dreiss/barrel-power-monitor/back-side.jpg

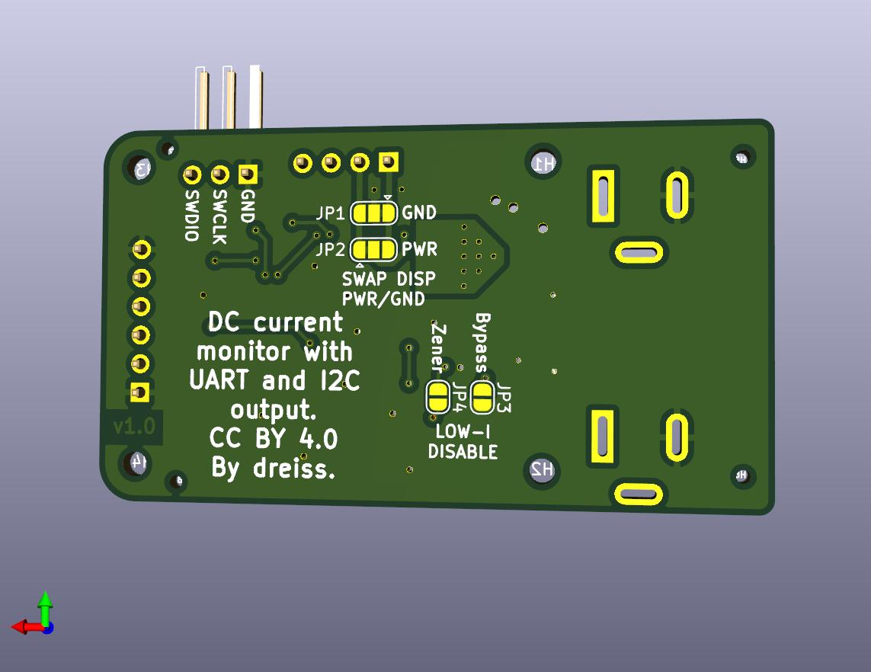
back-side.jpg
