dreiss/barrel-power-monitor/render.jpg

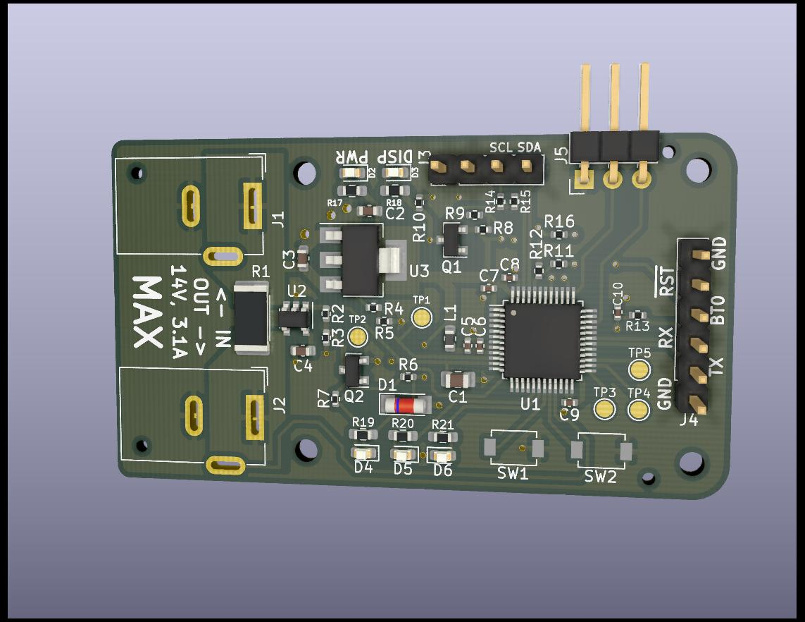
render.jpg
