dreiss/barrel-power-monitor/pcb-screenshot.png

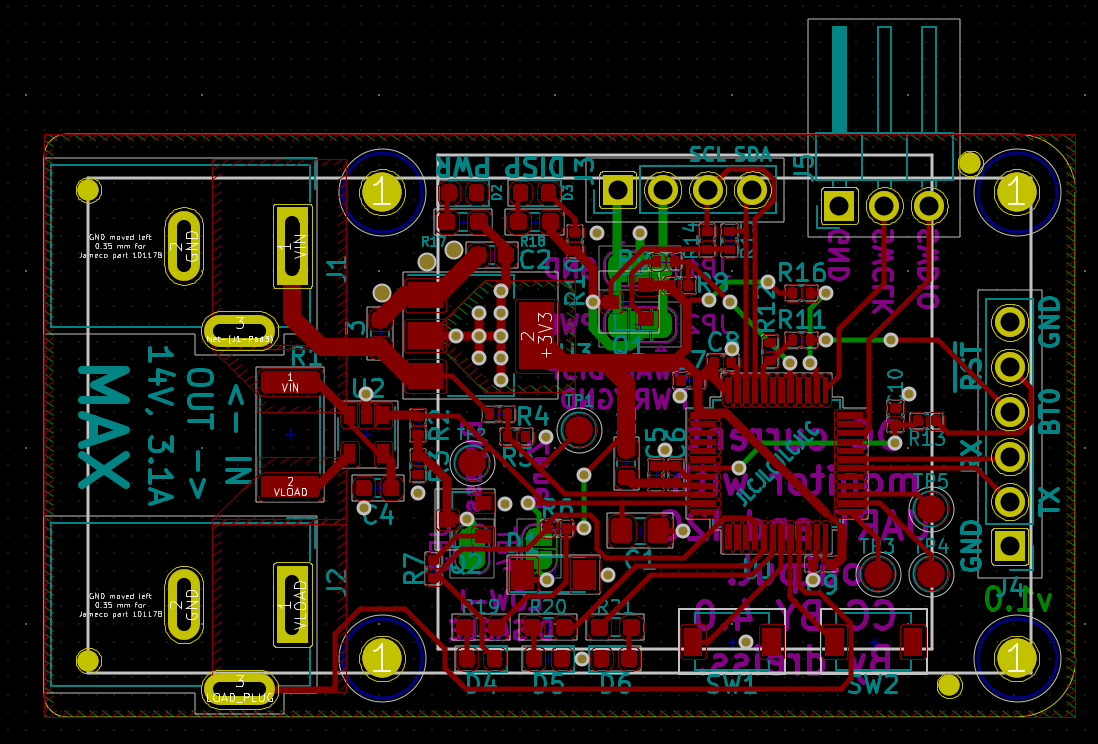
pcb-screenshot.png
