dreiss/barrel-power-monitor/schematic-screenshot.png

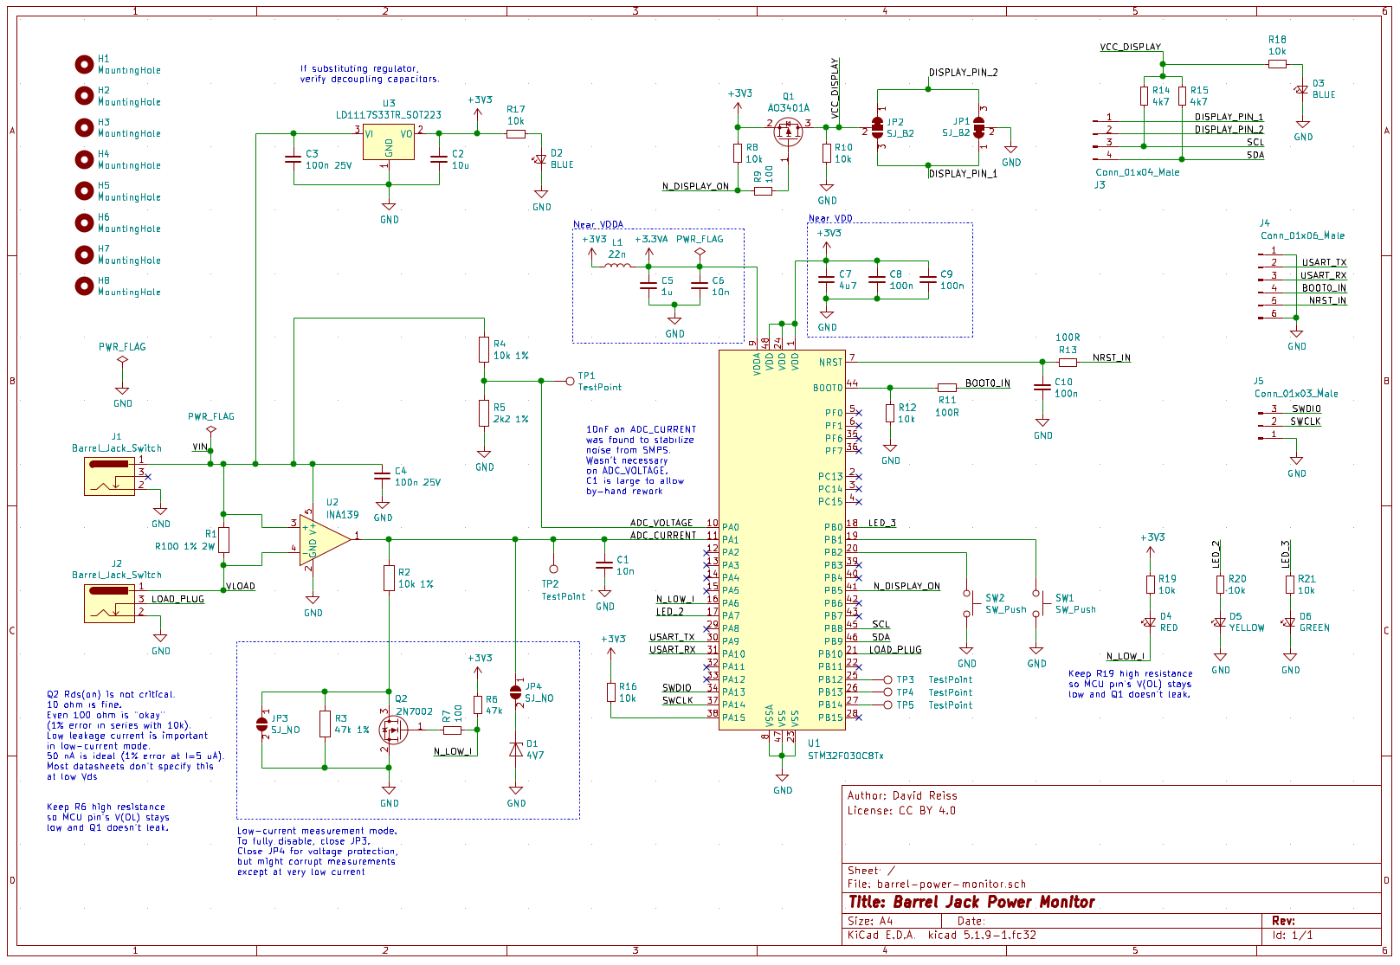
schematic-screenshot.png
