dreiss/barrel-power-monitor/schematic.pdf

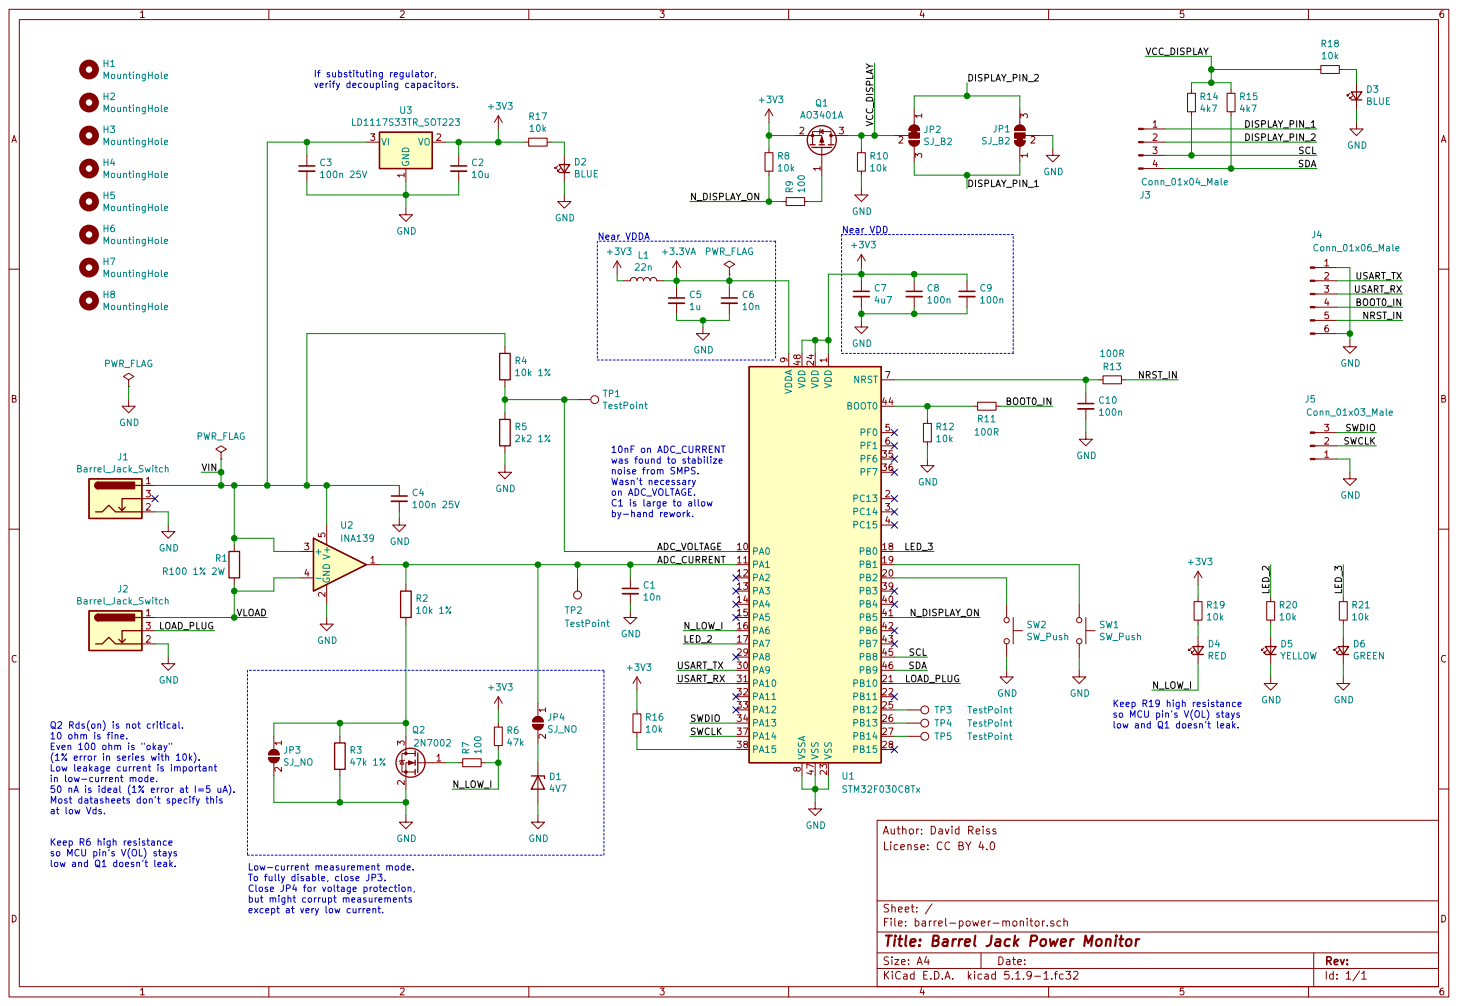
[picture p5: page 1]

Near VDD Near VDDA

1 PA0 10 PA1 11 PA2 12 PA3 13 PA4 14 PA5 15 PA6 16 PA7 17 PB0 18 PB1 19 PC13 2 PB2 20 PB10 21 PB11 22 VSS 23 VDD 24 PB12 25 PB13 26 PB14 27 PB15 28 PA8 29 PC14 3 PA9 30 PA10 31 PA11 32 PA12 33 PA13 34 PF6 35 PF7 36 PA14 37 PA15 38 PB3 39 PC15 4 PB4 40 PB5 41 PB6 42 PB7 43 BOOT0 44 PB8 45 PB9 46 VSS 47 VDD 48 PF0 5 PF1 6 NRST 7 VSSA

10nF on ADC_CURRENT was found to stabilize

noise from SMPS. Wasn't necessary on ADC_VOLTAGE. C1 is large to allow

Keep R19 high resistance
so MCU pin's V(OL) stays
low and Q1 doesn't leak.

Q2 Rds(on) is not critical. 10 ohm is fine. Even 100 ohm is "okay"

(1% error in series with 10k).
Low leakage current is important
in low-current mode. 50 nA is ideal (1% error at I=5 uA).

Most datasheets don't specify this at low Vds.

File: barrel-power-monitor.sch Sheet: / License: CC BY 4.0 Author: David Reiss

Keep R6 high resistance

Low-current measurement mode. To fully disable, close JP3.

Close JP4 for voltage protection,
but might corrupt measurements
except at very low current.

Id: 1/1 Title: Barrel Jack Power Monitor
