dreiss/barrel-power-monitor/hardware/barrel-power-monitor.kicad_pcb

## KiCad design hardware/barrel-power-monitor.kicad_pcb (2021-02-19)

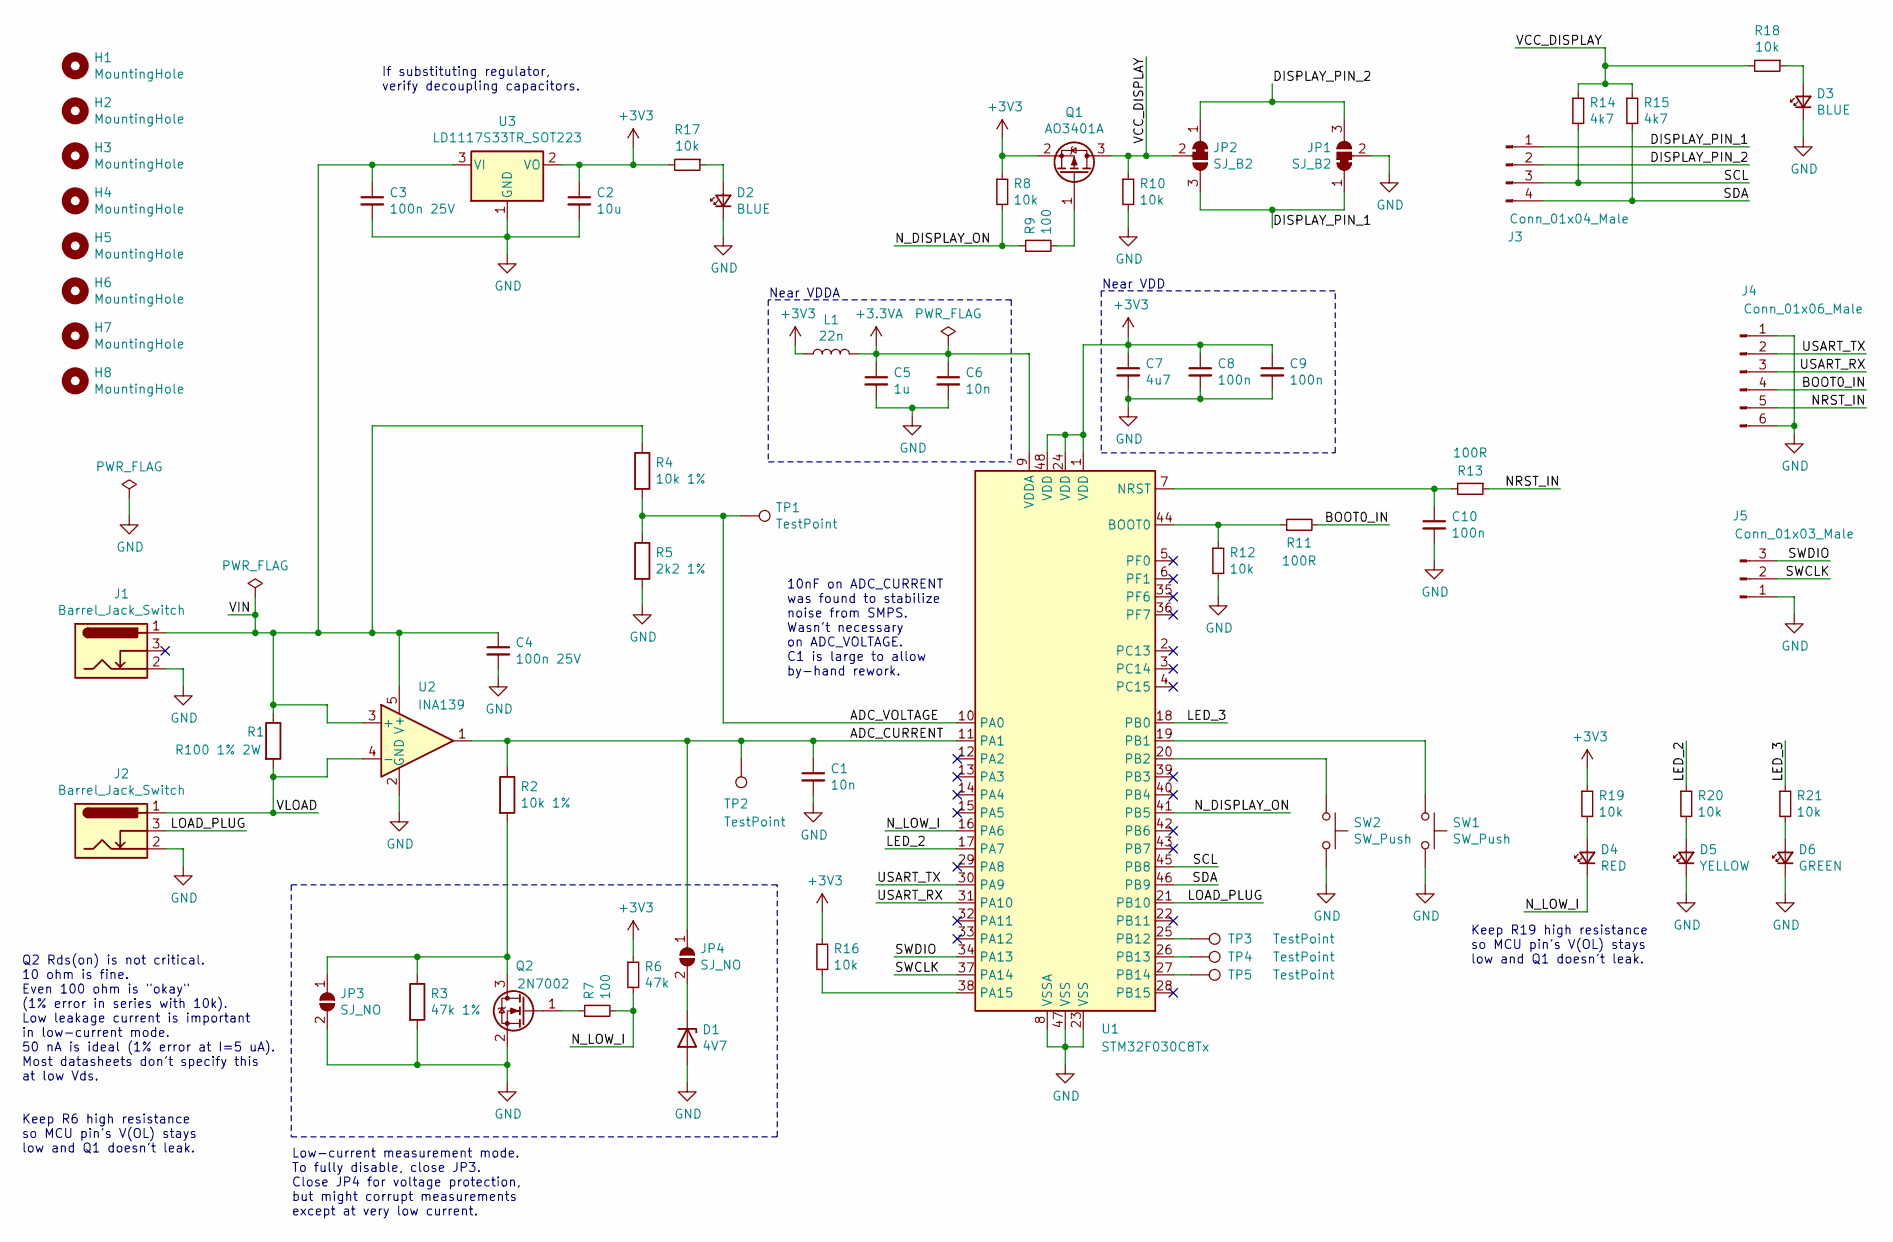
[picture p6: schematic barrel-power-monitor.sch, Barrel Jack Power Monitor]

Parts:
C1: 10n; C_0805_2012Metric_Pad1.18x1.45mm_HandSolder
C2: 10u; C_0603_1608Metric
C3, C4: 100n 25V; C_0603_1608Metric
C5: 1u; C_0402_1005Metric
C6: 10n; C_0402_1005Metric
C7: 4u7; C_0402_1005Metric
C8, C9, C10: 100n; C_0402_1005Metric
D1: 4V7; D_MiniMELF
D2, D3: BLUE; LED_0603_1608Metric; LCSC C72041
D4: RED; LED_0603_1608Metric; LCSC C2286
D5: YELLOW; LED_0603_1608Metric; LCSC C72042
D6: GREEN; LED_0603_1608Metric; LCSC C72043
H1, H2, H3, H4: MountingHole; MountingHole_2.2mm_M2
H5, H6, H7, H8: MountingHole; JLCPCB-Tooling-Hole
J1, J2: Barrel_Jack_Switch; BarrelJack_Wuerth_6941xx301002
J3: Conn_01x04_Male; PinHeader_1x04_P2.54mm_Vertical
J4: Conn_01x06_Male; PinHeader_1x06_P2.54mm_Vertical
J5: Conn_01x03_Male; PinHeader_1x03_P2.54mm_Horizontal
JP1, JP2: SJ_B2; SolderJumper-3_P1.3mm_Bridged12_RoundedPad1.0x1.5mm
JP3, JP4: SJ_NO; SolderJumper-2_P1.3mm_Open_RoundedPad1.0x1.5mm
L1: 22n; L_0603_1608Metric
Q1: AO3401A; SOT-23
Q2: 2N7002; SOT-23
R1: R100 1% 2W; R_2512_6332Metric; LCSC C76254
R2, R4: 10k 1%; R_0402_1005Metric
R3: 47k 1%; R_0402_1005Metric
R5: 2k2 1%; R_0402_1005Metric
R6: 47k; R_0402_1005Metric
R7, R9: 100; R_0402_1005Metric
R8, R10, R12, R16: 10k; R_0402_1005Metric
R11, R13: 100R; R_0402_1005Metric
R14, R15: 4k7; R_0402_1005Metric
R17, R18, R19, R20, R21: 10k; R_0603_1608Metric_Pad0.98x0.95mm_HandSolder
SW1, SW2: SW_Push; GT-TC029X-H0XX-L1N; LCSC C843669
TP1, TP2, TP3, TP4, TP5: TestPoint; TestPoint_Pad_D1.5mm
U1: STM32F030C8Tx; LQFP-48_7x7mm_P0.5mm
U2: INA139; SOT-23-5
U3: LD1117S33TR_SOT223; SOT-223-3_TabPin2

Connections:
+3.3VA: C5.1, C6.1, L1.2, U1.9 (VDDA)
+3V3: C2.1, C7.1, C8.1, C9.1, L1.1, Q1.2 (S), R6.1, R8.1, R16.1, R17.2, R19.1, U1.1 (VDD), U1.24 (VDD), U1.48 (VDD), U3.2 (VO)
/ADC_CURRENT: C1.1, JP4.1 (A), R2.1, TP2.1, U1.11 (PA1), U2.1
/ADC_VOLTAGE: R4.2, R5.1, TP1.1, U1.10 (PA0)
/BOOT0_IN: J4.4, R11.2
/DISPLAY_PIN_1: J3.1, JP1.1 (A), JP2.3 (B)
/DISPLAY_PIN_2: J3.2, JP1.3 (B), JP2.1 (A)
/LED_2: R20.1, U1.17 (PA7)
/LED_3: R21.1, U1.18 (PB0)
/LOAD_PLUG: J2.3, U1.21 (PB10)
/NRST_IN: J4.5, R13.1
/N_DISPLAY_ON: R8.2, R9.1, U1.41 (PB5)
/N_LOW_I: D4.1 (K), R6.2, R7.2, U1.16 (PA6)
/SCL: J3.3, R14.2, U1.45 (PB8)
/SDA: J3.4, R15.2, U1.46 (PB9)
/SWCLK: J5.2, U1.37 (PA14)
/SWDIO: J5.3, U1.34 (PA13)
/USART_RX: J4.3, U1.31 (PA10)
/USART_TX: J4.2, U1.30 (PA9)
/VCC_DISPLAY: JP2.2 (C), Q1.3 (D), R10.1, R14.1, R15.1, R18.2
/VIN: C3.1, C4.1, J1.1, R1.1, R4.1, U2.3 (+), U2.5 (V+), U3.3 (VI)
/VLOAD: J2.1, R1.2, U2.4 (-)
GND: C1.2, C2.2, C3.2, C4.2, C5.2, C6.2, C7.2, C8.2, C9.2, C10.2, D1.2 (A), D2.1 (K), D3.1 (K), D5.1 (K), D6.1 (K), J1.2, J2.2, J4.1, J4.6, J5.1, JP1.2 (C), JP3.2 (B), Q2.2 (S), R3.2, R5.2, R10.2, R12.2, SW1.2, SW2.2, U1.8 (VSSA), U1.23 (VSS), U1.47 (VSS), U2.2 (GND), U3.1 (GND)
unnamed: C10.1, R13.2, U1.7 (NRST)
unnamed: D1.1 (K), JP4.2 (B)
unnamed: D2.2 (A), R17.1
unnamed: D3.2 (A), R18.1
unnamed: D4.2 (A), R19.2
unnamed: D5.2 (A), R20.2
unnamed: D6.2 (A), R21.2
unnamed: JP3.1 (A), Q2.3 (D), R2.2, R3.1
unnamed: Q1.1 (G), R9.2
unnamed: Q2.1 (G), R7.1
unnamed: R11.1, R12.1, U1.44 (BOOT0)
unnamed: R16.2, U1.38 (PA15)
unnamed: SW1.1, U1.19 (PB1)
unnamed: SW2.1, U1.20 (PB2)
unnamed: TP3.1, U1.25 (PB12)
unnamed: TP4.1, U1.26 (PB13)
unnamed: TP5.1, U1.27 (PB14)

Notes on the sheet:
Near VDD
Low-current measurement mode. To fully disable, close JP3. Close JP4 for voltage protection, but might corrupt measurements except at very low current.
Q2 Rds(on) is not critical. 10 ohm is fine. Even 100 ohm is "okay" (1% error in series with 10k). Low leakage current is important in low-current mode. 50 nA is ideal (1% error at I=5 uA). Most datasheets don't specify this at low Vds.
Near VDDA
If substituting regulator, verify decoupling capacitors.
Keep R19 high resistance so MCU pin's V(OL) stays low and Q1 doesn't leak.
10nF on ADC_CURRENT was found to stabilize noise from SMPS. Wasn't necessary on ADC_VOLTAGE. C1 is large to allow by-hand rework.
Keep R6 high resistance so MCU pin's V(OL) stays low and Q1 doesn't leak.

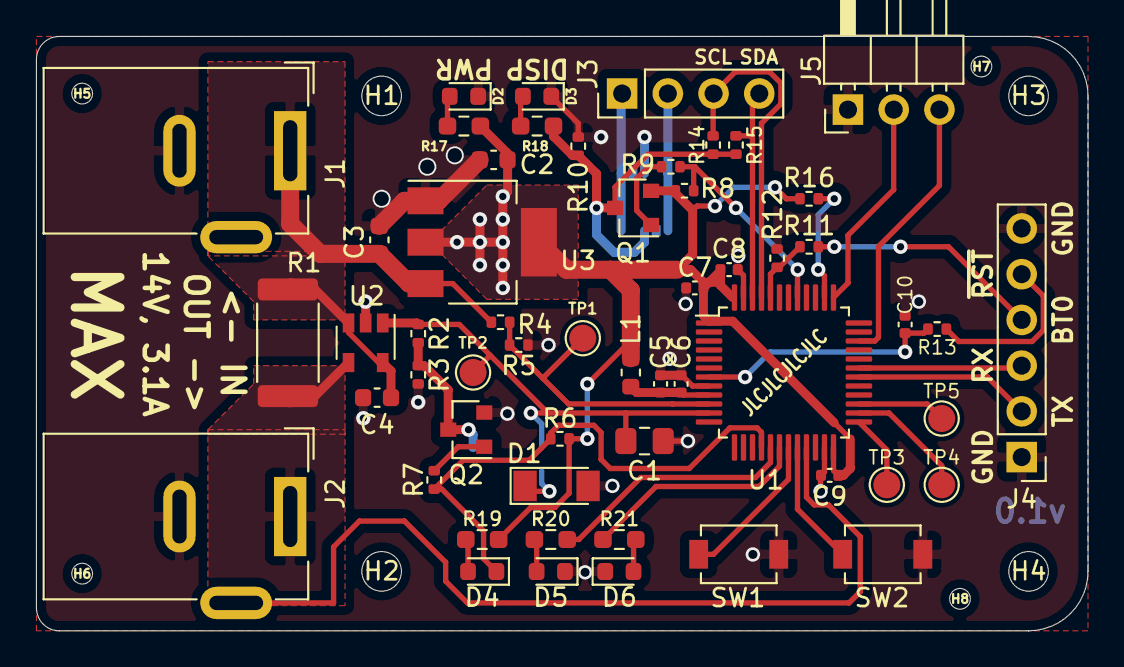
[picture p7: board barrel-power-monitor.kicad_pcb from above]

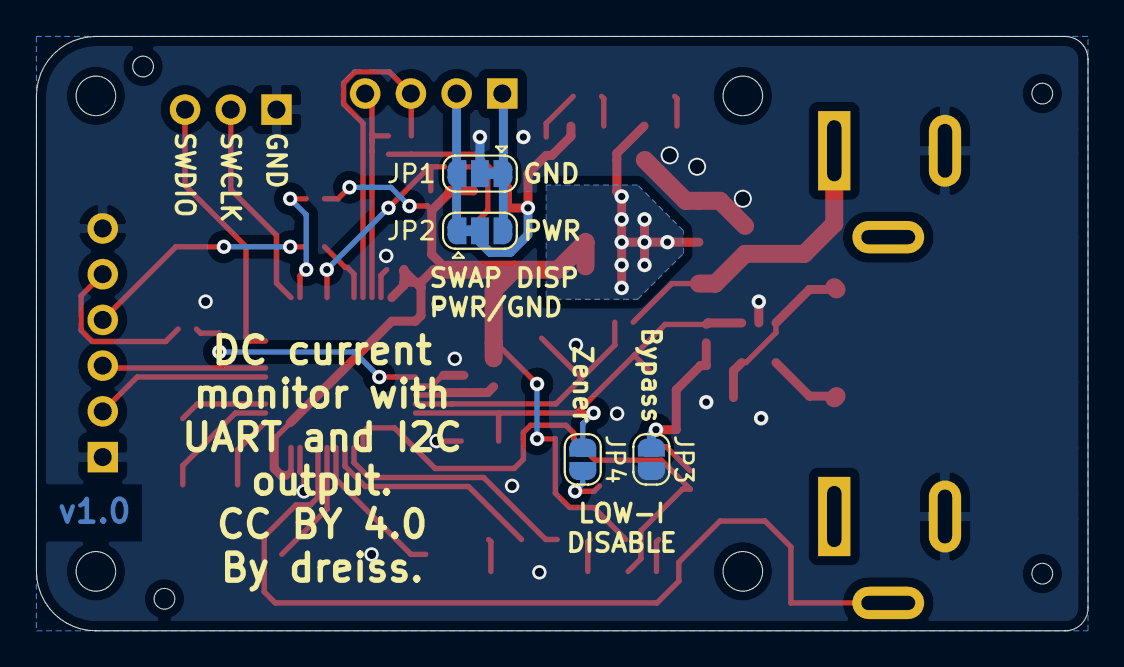
[picture p8: board barrel-power-monitor.kicad_pcb from below]

Board: 2 copper layers, 58.4 x 33.0 mm, 67 parts (4 on the bottom side), 40 nets.
